LRNATHD/Kicad-Design-Library/README.md

# Kicad Design Library
all the various footprints/schematics/3d models I use
