LRNATHD/Kicad-Design-Library/Footprint/SW_Cherry_MX_Plate.stp

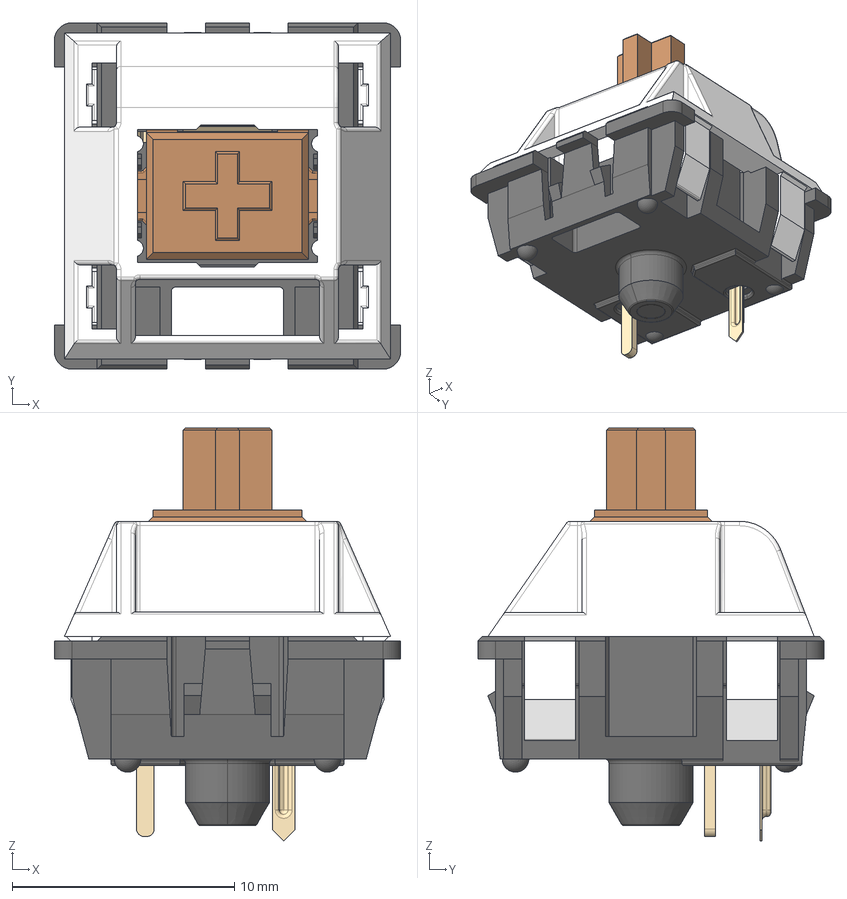
[picture p1: CAD file, 2025-10-21]
Footprint/SW_Cherry_MX_Plate.stp
15.6 x 15.6 x 18.6 mm
