LRNATHD/Kicad-Design-Library/Footprint/usbc.step

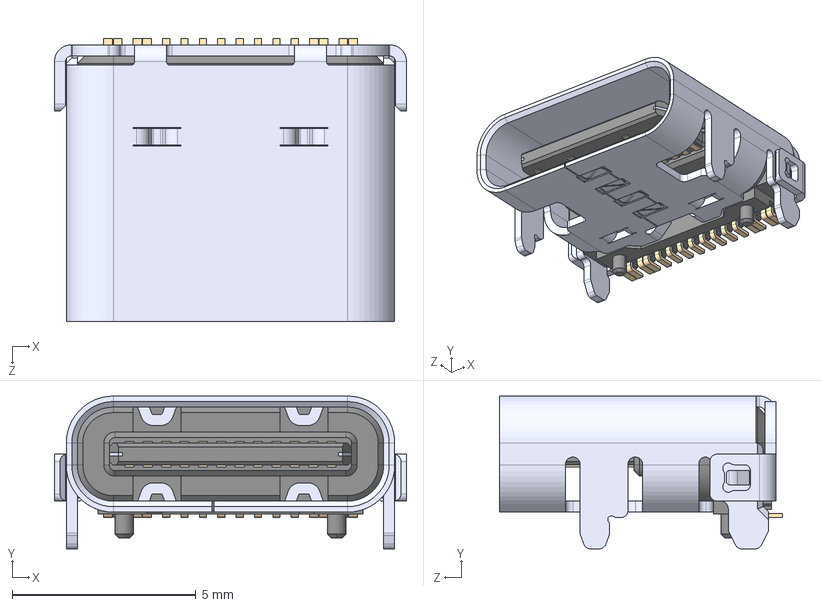
[picture p2: CAD file, 2025-09-08]
Footprint/usbc.step
9.58 x 4.16 x 7.71 mm
