LRNATHD/Kicad-Design-Library/Footprint/voltage regulator.stp

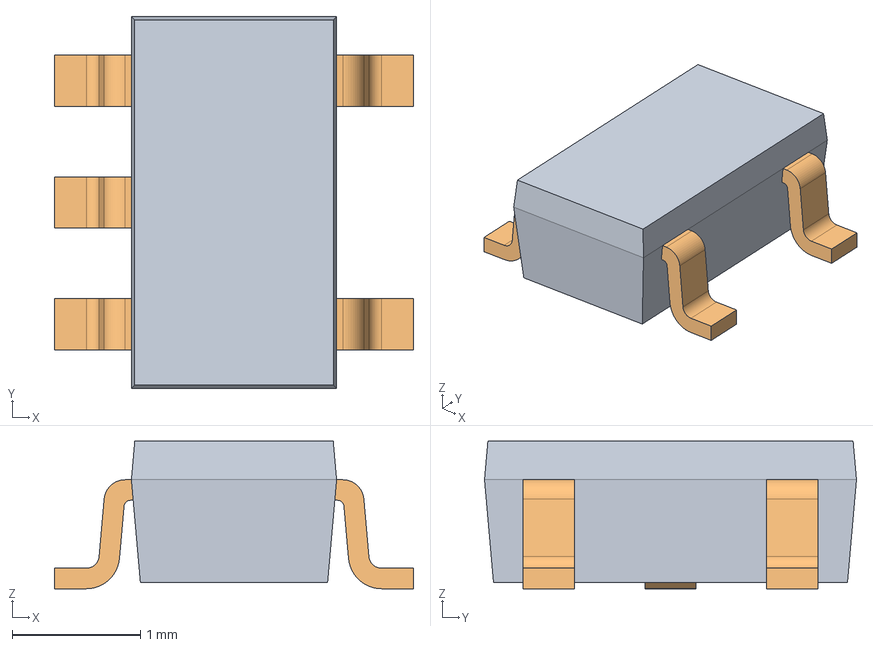
[picture p3: CAD file, 2025-09-08]
Footprint/voltage regulator.stp
2.80 x 2.90 x 1.15 mm
