LRNATHD/Kicad-Design-Library/Footprint/ceramic antenna.step

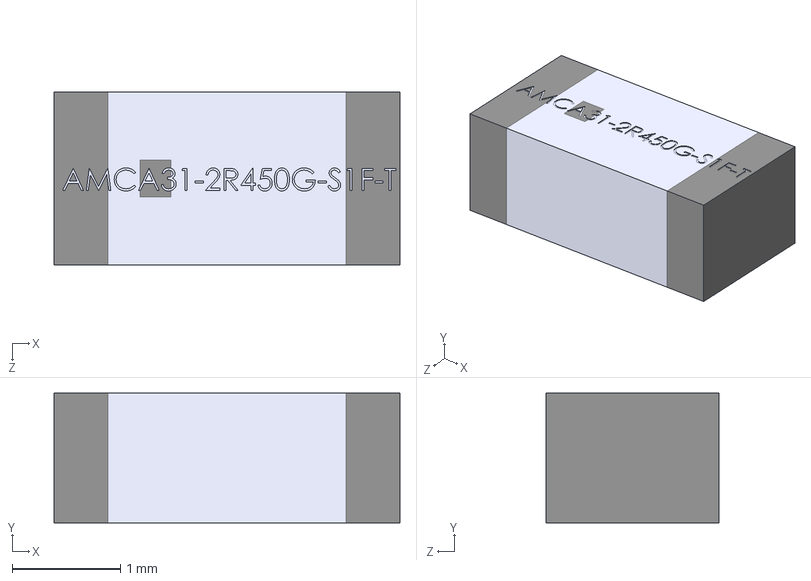
[picture p4: CAD file, 2025-07-16]
Footprint/ceramic antenna.step
3.20 x 1.20 x 1.60 mm
