LRNATHD/Kicad-Design-Library/Footprint/button.step

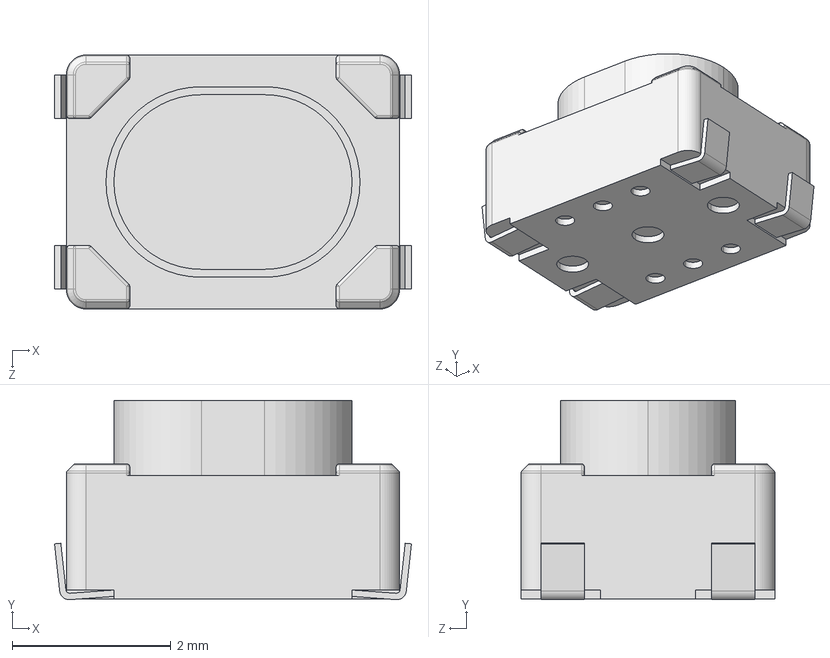
[picture p5: CAD file, 2025-07-09]
Footprint/button.step
4.50 x 2.51 x 3.20 mm
