LRNATHD/Kicad-Design-Library/Footprint/32mhz crystal.step

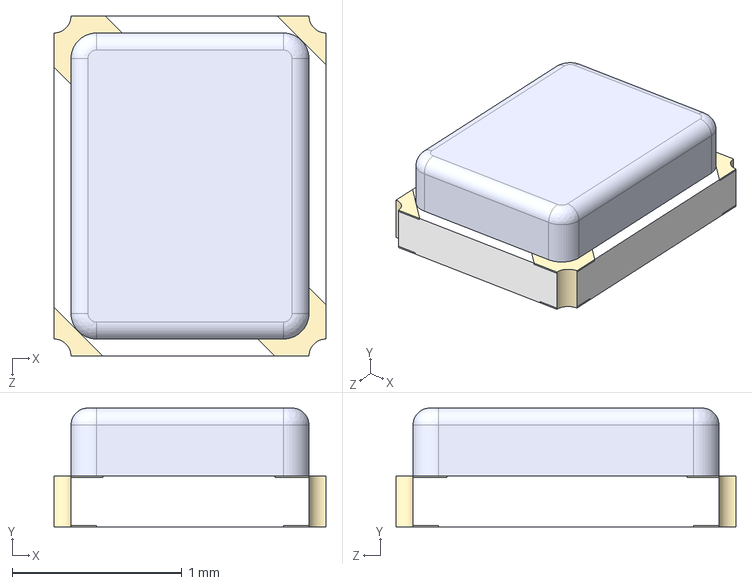
[picture p6: CAD file, 2025-07-09]
Footprint/32mhz crystal.step
1.60 x 0.7 x 2.00 mm
