LRNATHD/Kicad-Design-Library/Footprint/0603.step

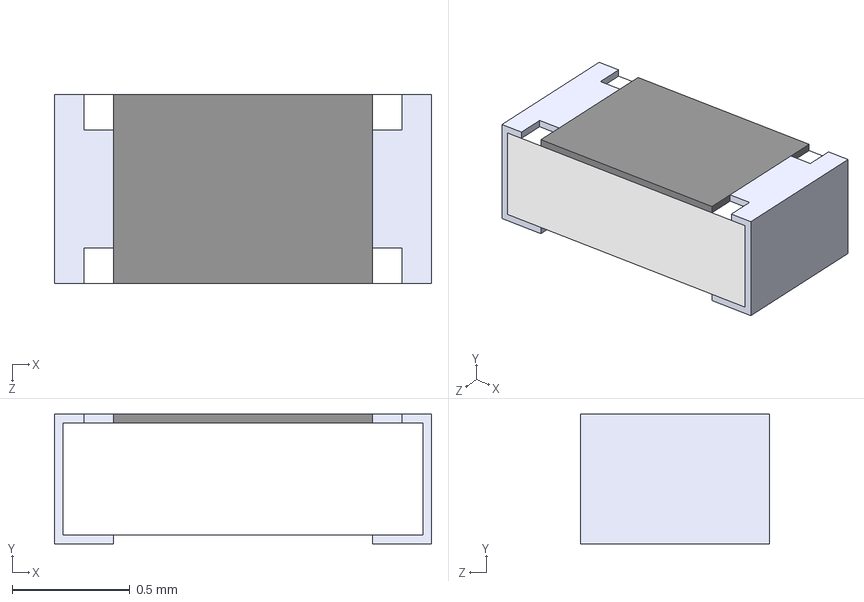
[picture p7: CAD file, 2025-07-08]
Footprint/0603.step
1.60 x 0.55 x 0.8 mm
