LRNATHD/Kicad-Design-Library/DesignBlockskicad_blocks.kicad_blocks/3.3v Voltage Regulator Compact.kicad_block/3.3v Voltage Regulator Compact.kicad_sch

## KiCad design DesignBlockskicad_blocks.kicad_blocks/3.3v Voltage Regulator Compact.kicad_block/3.3v Voltage Regulator Compact.kicad_sch (2025-11-30)

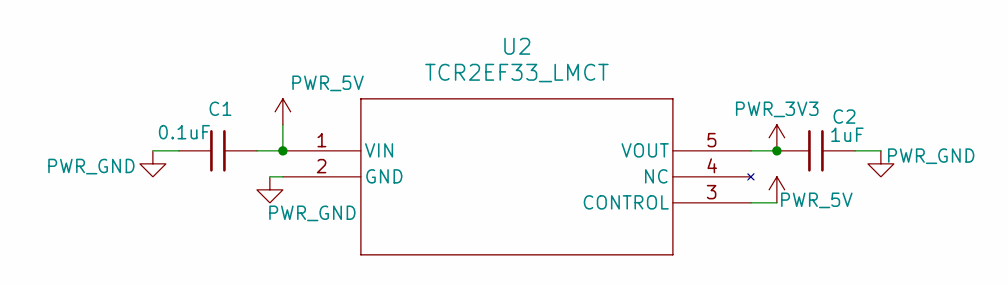
[picture p8: schematic 3.3v Voltage Regulator Compact.kicad_sch]

Parts:
C1: 0.1uF; C_0603
C2: 1uF; C_0603
U2: TCR2EF33_LMCT; voltage regulator

Connections:
PWR_3V3: C2.1, U2.5 (VOUT)
PWR_5V: C1.2, U2.1 (VIN), U2.3 (CONTROL)
PWR_GND: C1.1, C2.2, U2.2 (GND)
