LRNATHD/Kicad-Design-Library/DesignBlockskicad_blocks.kicad_blocks/4057 prepped.kicad_block/4057 prepped.kicad_sch

## KiCad design DesignBlockskicad_blocks.kicad_blocks/4057 prepped.kicad_block/4057 prepped.kicad_sch (2026-03-02)

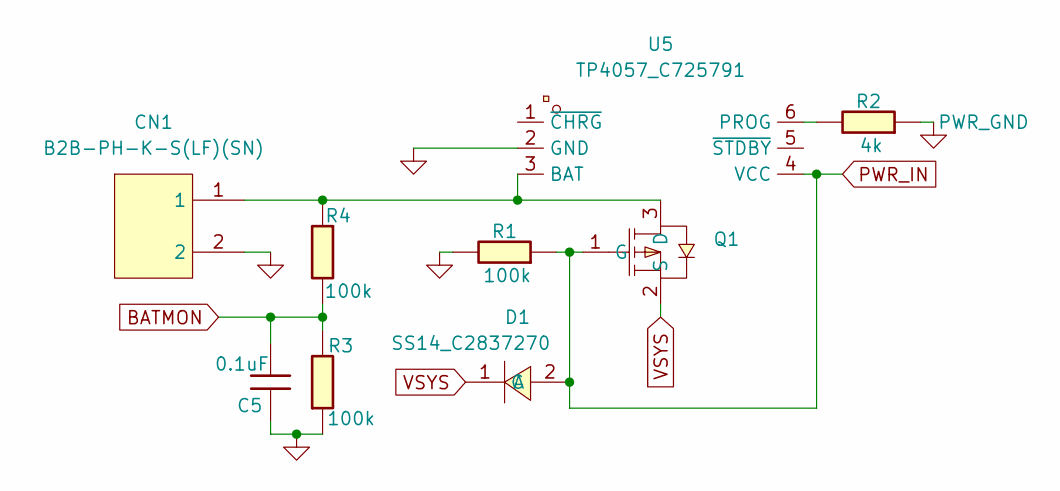
[picture p9: schematic 4057 prepped.kicad_sch]

Parts:
C5: 0.1uF; 0603
CN1: B2B-PH-K-S(LF)(SN); CONN-TH_B2B-PH-K-S; LCSC Part C131337
D1: SS14_C2837270; SMA_L4.3-W2.6-LS5.0-RD; LCSC Part C2837270
Q1: AO3401A; SOT-23_L2.9-W1.3-P1.90-LS2.4-BR; LCSC Part C15127
R1, R3, R4: 100k; 0603
R2: 4k; 0603
U5: TP4057_C725791; SOT-23-6_L2.9-W1.6-P0.95-LS2.8-BR; LCSC Part C725791

Connections:
BATMON: C5.2, R3.1, R4.1
unnamed: CN1.1, Q1.3 (D), R4.2, U5.3 (BAT)
unnamed: R2.1, U5.6 (PROG)
PWR_GND: C5.1, CN1.2, R1.1, R2.2, R3.2, U5.2 (GND)
PWR_IN: D1.2 (A), Q1.1 (G), R1.2, U5.4 (VCC)
VSYS: D1.1 (C), Q1.2 (S)
