LRNATHD/Kicad-Design-Library/DesignBlockskicad_blocks.kicad_blocks/CH572D.kicad_block/CH572D.kicad_sch

## KiCad design DesignBlockskicad_blocks.kicad_blocks/CH572D.kicad_block/CH572D.kicad_sch (2026-03-02)

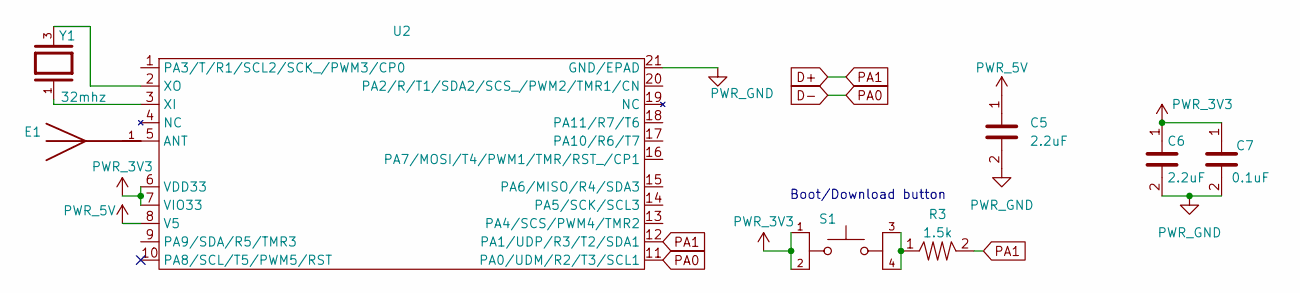
[picture p10: schematic CH572D.kicad_sch]

Parts:
C5, C6: 2.2uF; 0603
C7: 0.1uF; 0603
E1: AMCA31-2R450G-S1F-T3; XDCR_AMCA31-2R450G-S1F-T3; PARTREV 03-21-19
R3: 1.5k; 0603
S1: TL3365AF180QG; button; PARTREV A
U2: CH572D
Y1: 32mhz; 32mhz crystal; PARTREV N/A

Connections:
D+: R3.2, U2.12 (PA1/UDP/R3/T2/SDA1)
D-: U2.11 (PA0/UDM/R2/T3/SCL1)
unnamed: E1.1, U2.5 (ANT)
unnamed: R3.1, S1.3, S1.4
unnamed: U2.2 (XO), Y1.3
unnamed: U2.3 (XI), Y1.1
PWR_3V3: C6.1, C7.1, S1.1, S1.2, U2.6 (VDD33), U2.7 (VIO33)
PWR_5V: C5.1, U2.8 (V5)
PWR_GND: C5.2, C6.2, C7.2, U2.21 (GND/EPAD)

Notes on the sheet:
Boot/Download button
