LRNATHD/Kicad-Design-Library/DesignBlockskicad_blocks.kicad_blocks/CH592X first attempt.kicad_block/CH592X first attempt.kicad_sch

## KiCad design DesignBlockskicad_blocks.kicad_blocks/CH592X first attempt.kicad_block/CH592X first attempt.kicad_sch (2025-12-03)

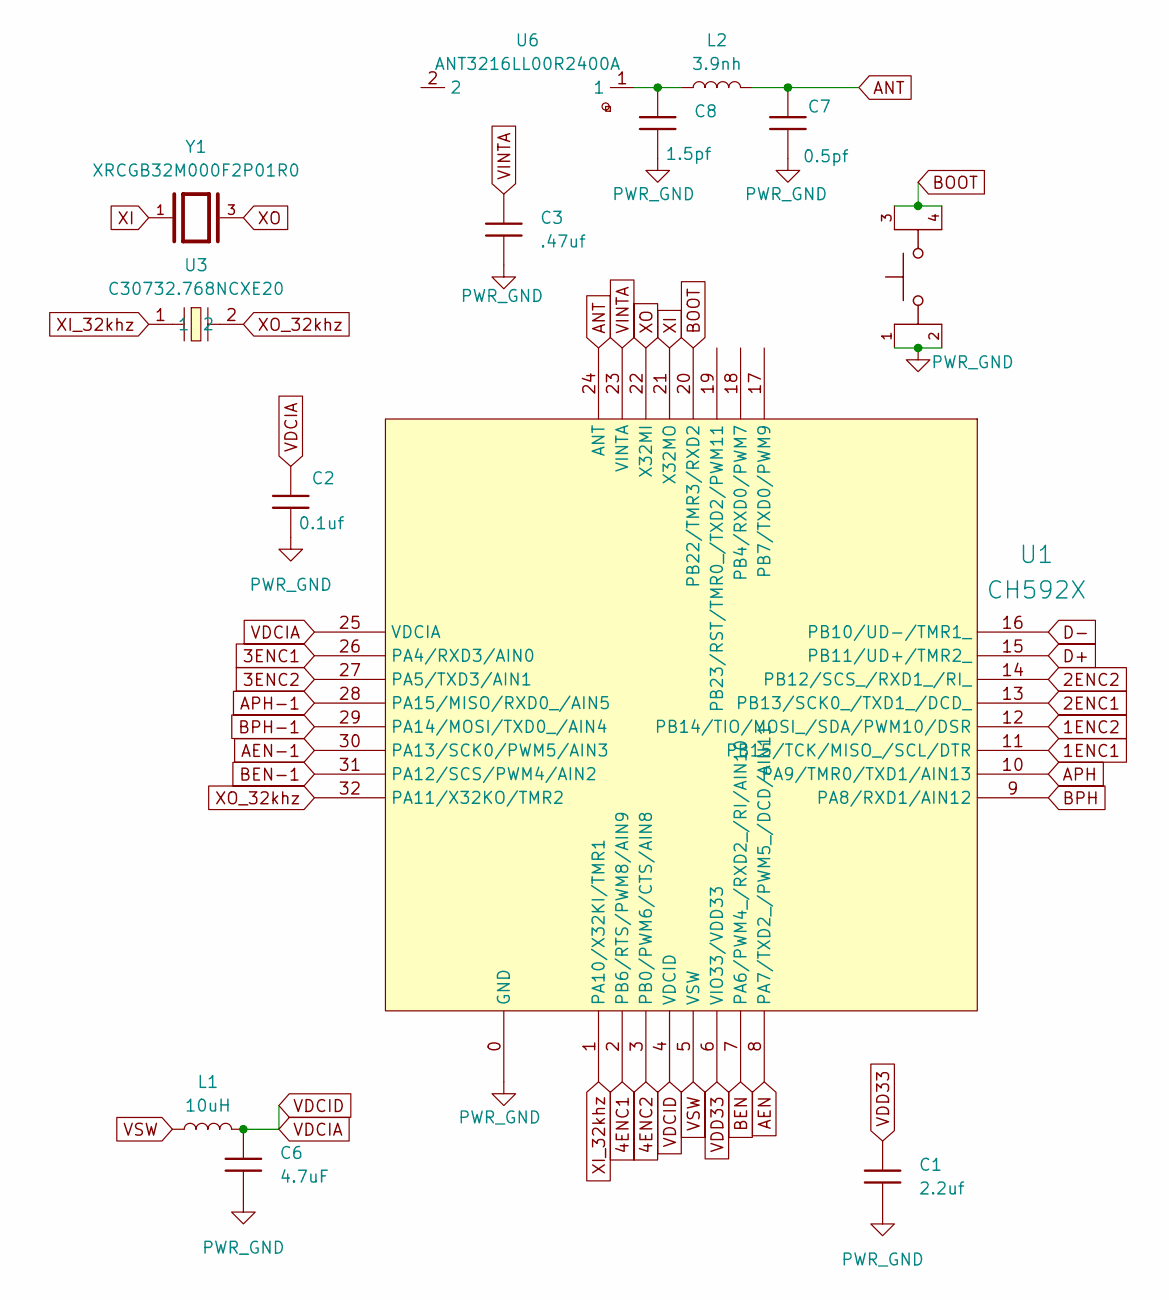
[picture p11: schematic CH592X first attempt.kicad_sch]

Parts:
C1: 2.2uf; C_0603
C2: 0.1uf; C_0603
C3: .47uf; C_0603
C6: 4.7uF; C_0603
C7: 0.5pf; C_0603
C8: 1.5pf; C_0603
L1: 10uH; 0603
L2: 3.9nh; 0603
S2: TL3365AF180QG; button; PARTREV A
U1: CH592X; QFN32_4X4
U3: C30732.768NCXE20; HC-49S_L7.2-W3.2; LCSC Part C19725234
U6: ANT3216LL00R2400A; ANT-SMD_L3.2-W1.6; LCSC Part C293767
Y1: XRCGB32M000F2P01R0; 32mhz crystal; PARTREV N/A

Connections:
1ENC1: U1.11 (PB15/TCK/MISO_/SCL/DTR)
1ENC2: U1.12 (PB14/TIO/MOSI_/SDA/PWM10/DSR)
2ENC1: U1.13 (PB13/SCK0_/TXD1_/DCD_)
2ENC2: U1.14 (PB12/SCS_/RXD1_/RI_)
3ENC1: U1.26 (PA4/RXD3/AIN0)
3ENC2: U1.27 (PA5/TXD3/AIN1)
4ENC1: U1.2 (PB6/RTS/PWM8/AIN9)
4ENC2: U1.3 (PB0/PWM6/CTS/AIN8)
AEN: U1.8 (PA7/TXD2_/PWM5_/DCD/AIN11)
AEN-1: U1.30 (PA13/SCK0/PWM5/AIN3)
ANT: C7.1, L2.2, U1.24 (ANT)
APH: U1.10 (PA9/TMR0/TXD1/AIN13)
APH-1: U1.28 (PA15/MISO/RXD0_/AIN5)
BEN: U1.7 (PA6/PWM4_/RXD2_/RI/AIN10)
BEN-1: U1.31 (PA12/SCS/PWM4/AIN2)
BOOT: S2.3, S2.4, U1.20 (PB22/TMR3/RXD2)
BPH: U1.9 (PA8/RXD1/AIN12)
BPH-1: U1.29 (PA14/MOSI/TXD0_/AIN4)
D+: U1.15 (PB11/UD+/TMR2_)
D-: U1.16 (PB10/UD-/TMR1_)
unnamed: C8.1, L2.1, U6.1
PWR_GND: C1.2, C2.1, C3.1, C6.2, C7.2, C8.2, S2.1, S2.2, U1.0 (GND)
VDCIA: C2.2, C6.1, L1.2, U1.4 (VDCID), U1.25 (VDCIA)
VDD33: C1.1, U1.6 (VIO33/VDD33)
VINTA: C3.2, U1.23 (VINTA)
VSW: L1.1, U1.5 (VSW)
XI: U1.21 (X32MO), Y1.1
XI_32khz: U1.1 (PA10/X32KI/TMR1), U3.1
XO: U1.22 (X32MI), Y1.3
XO_32khz: U1.32 (PA11/X32KO/TMR2), U3.2
