LRNATHD/Kicad-Design-Library/DesignBlockskicad_blocks.kicad_blocks/Load Sharing TP4057.kicad_block/Load Sharing TP4057.kicad_sch

## KiCad design DesignBlockskicad_blocks.kicad_blocks/Load Sharing TP4057.kicad_block/Load Sharing TP4057.kicad_sch (2025-12-02)

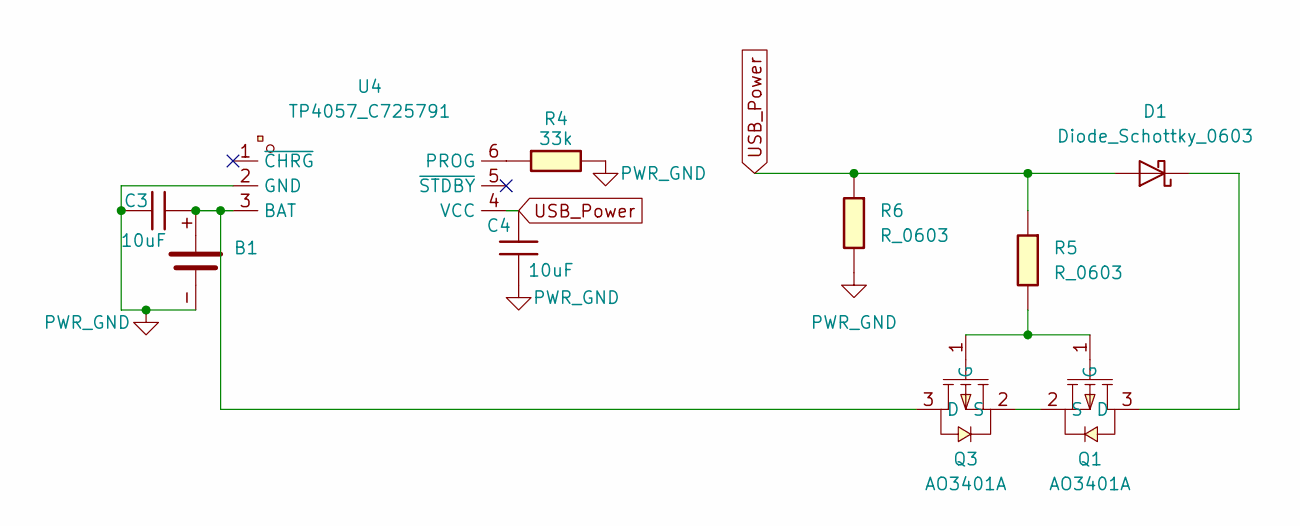
[picture p12: schematic Load Sharing TP4057.kicad_sch]

Parts:
B1: supersmallbattery
C3, C4: 10uF; C_0603
D1: Diode_Schottky_0603
Q1, Q3: AO3401A; SOT-23_L2.9-W1.3-P1.90-LS2.4-BR; LCSC Part C15127
R4: 33k; 0603
R5, R6: R_0603
U4: TP4057_C725791; SOT-23-6_L2.9-W1.6-P0.95-LS2.8-BR; LCSC Part C725791

Connections:
unnamed: B1.+, C3.2, Q3.3 (D), U4.3 (BAT)
unnamed: D1.1 (K), Q1.3 (D)
unnamed: Q1.1 (G), Q3.1 (G), R5.1
unnamed: Q1.2 (S), Q3.2 (S)
unnamed: R4.2, U4.6 (PROG)
PWR_GND: B1.-, C3.1, C4.1, R4.1, R6.1, U4.2 (GND)
USB_Power: C4.2, D1.2 (A), R5.2, R6.2, U4.4 (VCC)
