LRNATHD/Kicad-Design-Library/DesignBlockskicad_blocks.kicad_blocks/Simple Antenna.kicad_block/Simple Antenna.kicad_sch

## KiCad design DesignBlockskicad_blocks.kicad_blocks/Simple Antenna.kicad_block/Simple Antenna.kicad_sch (2025-12-05)

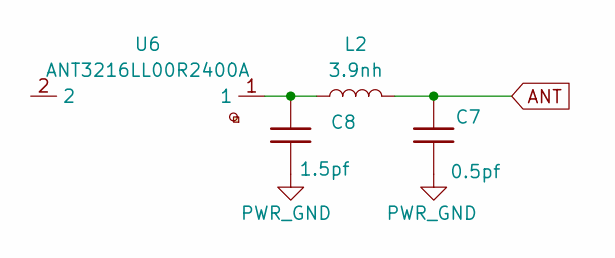
[picture p13: schematic Simple Antenna.kicad_sch]

Parts:
C7: 0.5pf; C_0603
C8: 1.5pf; C_0603
L2: 3.9nh; 0603
U6: ANT3216LL00R2400A; ANT-SMD_L3.2-W1.6; LCSC Part C293767

Connections:
ANT: C7.1, L2.2
unnamed: C8.1, L2.1, U6.1
PWR_GND: C7.2, C8.2
