LRNATHD/Kicad-Design-Library/DesignBlockskicad_blocks.kicad_blocks/USB C simple.kicad_block/USB C simple.kicad_sch

## KiCad design DesignBlockskicad_blocks.kicad_blocks/USB C simple.kicad_block/USB C simple.kicad_sch (2025-11-30)

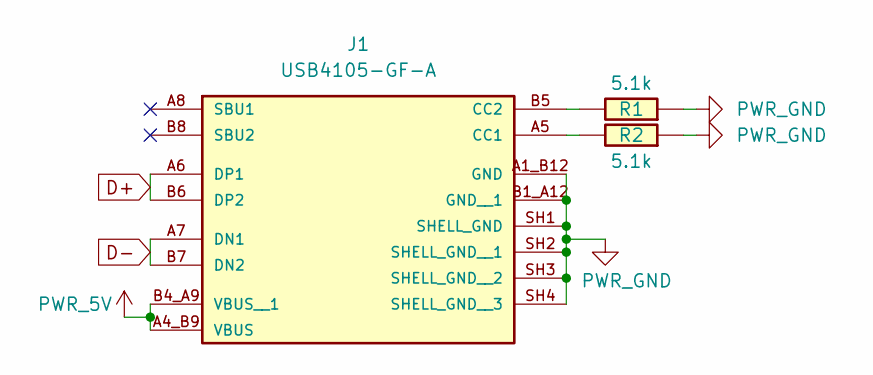
[picture p14: schematic USB C simple.kicad_sch]

Parts:
J1: USB4105-GF-A; GCT_USB4105-GF-A; PARTREV B4
R1, R2: 5.1k; R_0603

Connections:
D+: J1.A6 (DP1), J1.B6 (DP2)
D-: J1.A7 (DN1), J1.B7 (DN2)
unnamed: J1.A5 (CC1), R2.1
unnamed: J1.B5 (CC2), R1.1
PWR_5V: J1.A4_B9 (VBUS), J1.B4_A9 (VBUS__1)
PWR_GND: J1.A1_B12 (GND), J1.B1_A12 (GND__1), J1.SH1 (SHELL_GND), J1.SH2 (SHELL_GND__1), J1.SH3 (SHELL_GND__2), J1.SH4 (SHELL_GND__3), R1.2, R2.2
