LRNATHD/Kicad-Design-Library/(commit log)

2025-07-08 added 0603
    [0603.step]
2025-07-09 made 0603 resistor smaller, added crystal footprint
    [32mhz crystal.step]
2025-07-09 added button schematic
    I think its the picos button, hopefully its small
    [button.step]
2025-07-10 added the an043 antenna
2025-07-10 added antenna footprint
2025-07-16 removed added
    [ceramic antenna.step]
2025-08-28 added my antenna and usb c 3d files
    [usbc.step]
2025-09-08 moved around
    [usbc.step, voltage regulator.stp]
2025-10-07 added pcb usbA edge and maybe even USBC edge in a futgure life
2025-10-21 the button
    [SW_Cherry_MX_Plate.stp]
2025-11-30 added easyeda file, small battery, life good
    [3.3v Voltage Regulator Compact.kicad_sch, CH572D.kicad_sch, USB C simple.kicad_sch, geeked tp4057.kicad_sch]
2025-12-02 made a new block for the tp4057
    [Load Sharing TP4057.kicad_sch]
2025-12-03 new blocks, ch592x
    [CH592X first attempt.kicad_sch]
2025-12-05 worked on antenna, added some easyeda stuff
    [Simple Antenna.kicad_sch]
2026-03-02 a whole bunch of designs
    [4057 prepped.kicad_sch, CH572D.kicad_sch, I2C_Screen.kicad_sch, geeked tp4057.kicad_sch]
